vvatel/feline_follower/README.md

# Feline Follower (Autonomous Pet-Tracking Robot)
<strong>WORK IN PROGRESS</strong>
<p>An autonomous mobile robot that utilizes real-time visual tracking and SLAM-based navigation to follow the fast, erratic motions of a Felis catus in a real, unmapped and obstacle-ridden environment. Specifically, this robot will be tracking my own cat, Calypso, around my room and the hallways of the floor where I live.</p>
<p align="center">calypso</p>

## Details
<details><summary><ins><strong>Architecture</strong></ins></summary>
  
```
Desktop (ROS2/SLAM) <--Wi-Fi/ROS2--> Raspberry Pi 3B+ <--UART--> Arduino Uno R3 <--PWM--> TB6612FNG <--> 4x DC Motors
                                          ▲
                                          │ CSI
                                      Camera (OV5647)
```

</details>

<details>
<summary><strong><ins>Roadmap</ins></strong></summary>

<details><summary>Hardware: Data Exchange</summary>

#### Arduino <--> Motor Driver <--> Wheels

- [x] Verify TB6612 (motor driver) wiring on breadboard
- [x] Connect motor driver to Arduino Uno R3 using protoshield  
  *(need copper wire, soldering iron stand, solder sucker, cleaning sponge)*
- [x] Attach Uno to chassis, and connect DC motors to Uno through protoshield
- [x] Attach battery pack to chassis, and connect it to DC motors (as their power source) through motor driver
- [x] Verify that Uno is able to control all 4 wheels while attached to chassis

---

#### Raspberry Pi <--> Arduino

- [ ] Test UART communication only from Raspberry Pi 3B+ to Arduino Uno R3
- [ ] Using a breadboard, test UART communication from the Uno to Pi with a level shifter from 5V to 3.3V
- [ ] Solder level shifter to protoshield and set bi-directional UART communication through protoshield
- [ ] Verify communication between Pi and Uno
- [x] Create script for Uno to receive commands through Serial and write to motors
- [x] Verify that Pi is able to control all 4 wheels using Uno as intermediary

---

#### Desktop <--> Raspberry Pi

- [x] Figure out ROS2 communication between desktop and Raspberry Pi 3B+ over Wi-Fi  
  *(possibly need a router)*
- [x] Create bridge node on Pi for translating ROS2 Twist messages to workable PWM values that can be sent to Arduino
- [x] Verify that Pi is able to subscribe to topics, receive Twist messages, and use it to control the wheels

---

#### Desktop <--> Raspberry Pi <--> Arduino <--> Motor Driver <--> Wheels

- [ ] Verify full communication architecture with [Hand Controller](https://github.com/hcr-vvatel/hand_controller)

---

#### Camera <--> Raspberry Pi <--> Desktop

- [ ] Figure out how to send video feed from onboard camera to desktop

</details>

<details><summary>Software: Perception + Navigation</summary>

#### Perception Stack

- [ ] Research SLAM and find ROS2 implementations

---

#### Navigation Stack

- [ ] Figure out ROS2 Nav2 package

</details>
</details>

<details>
<summary><strong><ins>Timeline</ins></strong></summary>

<details><summary><strong>9/10/26</strong> - Conducted Testing to Calibrate Linear Speed to PWM Conversion</summary>
<p>Even though I could send Twist commands to my prototype vehicle, I still hadn't figured out how to make the car move as quickly or as slowly as I wanted. What PWM should I write to the motors such that they move the car at a specific linear speed. My first approach to solve this is to test the vehicle moving with different PWM percentages and seeing how long it takes it to travel 1 meter (for ease of conversion). For each PWM %, I collected 5 different run times so that I could average out any outliers in my data collection. Then, I used NumPy to fit a linear regression model predicting the underlying conversion equation and then plotted everything using MatPlotLib.</p>
  
Linear_Speed_Test_Figure_1
<p><b>Figure 9.10-1.</b> Each dot represents a different PWM % trialed, and the average of the 5 run times it took to travel 1 meter</p>
Linear_Speed_Test_Figure_2
<p><b>Figure 9.10-2.</b> Taking the inverse of the time reveals the underlying average speed of the vehicle at different PWM %'s</p>

<p>Using NumPy, I now had a model that could take in PWM %'s and predict the speed (m/s) that the vehicle would move at. Taking the inverse of this model now allows the vehicle to receive a specific speed (m/s) instruction (such as from a ROS2 Twist command) and have it output the PWM % it predicts the motors must receive to achieve that speed.</p>

<p><b>Notably:</b> I realize that this method will break if the underlying conversion equation changes for any reason such as differences in terrain or even battery output. In the future, I will look into closing the loop and using a sensor to determine the vehicle's actual speed and modify the PWM output in real time to reach a desired speed, but for now I'll simply try to replicate the testing conditions in which the data was collected as much as possible!</p>

</details>

---

<details><summary><strong>8/24/26</strong> - Completed first prototype of the Feline Follower</summary>
<p>Once I got all the motor wiring done, the final steps were just to put everything together, making sure to optimize the limited space that I had and the weight distribution of all the components.</p>

https://github.com/user-attachments/assets/06f4dbe5-0b82-4fd2-81a3-6a03bb42054f
<p><b>Figure 8.24-1.</b> Demo of FelineFollowerv1.0 spinning after receiving a ROS2 Twist command with only angular velocity</p>

<p>The full structure of this prototype includes a chassis with two layers. On the bottom layer is an Arduino Uno R3 velcroed to the frame controlling 4 Battery Operated DC Motors with a TB6612FNG Motor Driver. On the top layer, a rechargeable 12v battery pack which is used to power the motors and a power bank are velcroed to the frame. An encased Raspberry Pi 3B+ is velcroed to the top of the power bank which powers it. The Raspberry Pi is connected to a local router and listens to any Twist messages sent to the standard "/cmd_vel" topic, then translates those commands into PWM values sent through USB/Serial to the Arduino (this USB link also powers the Arduino), which then writes it to the motors.</p>

<p><b>Notably:</b> I didn't plan how to attach the camera to this build so I am planning to either buy a part that I can velcro onto the build and screw the camera into, or designing a custom part in CAD. I'm leaning towards designing a custom part since I don't have and want to gain experience with CAD, 3D Modeling and Printing, but this is supposed to be a computer vision project and I have already side-tracked quite a bit.

</details>

---

<details><summary><strong>8/19/26</strong> - Connected the motor's wires to the protoshield </summary>

<p>Now that I had the motor driver attached to the arduino, I could finally work on the wiring for the motors. Luckily, the protoshield that I used had multiple strips of connected holes allowing me to connect the motors and the motor driver easily.</p>
Motor Wiring
<p><b>Figure 8.19-1.</b> Motor <-> Motor Driver Wiring Diagram </p>

<p>Once I had finished wiring up the motors, I decided to test out the connections one more time before putting it all together. The Arduino was velcroed to the bottom layer of the frame, and the Raspberry Pi is running a <a href="ros2_ws/src/ros_serial_bridge/ros_serial_bridge/bridge.py">ROS2 node</a> that for now simply communicates through USB/Serial static PWM commands that the Arduino should write to the motors.</p>

https://github.com/user-attachments/assets/2925ada0-4e94-47b5-95f9-884456f6ebad
<p><b>Figure 8.19-2.</b> Demo of motors running while the wires are semi-permanenetly (soldered) to the Arduino</p>

</details>

---

<details> <summary><strong>8/16/26</strong> - Successfully connected motor driver to Arduino through protoshield </summary><br>

<p>Gathered the proper equipment including a new soldering iron, stand, a soldering tip cleaner, and copper wire. </p>

<p><b>Figure 8.16-1.</b> New protoshield held by recently acquired soldering stand</p>

<p>With all of this stuff, my second attempt at soldering the TB6612 onto the protoshield and then connecting it to the Arduino's pins was much cleaner. </p>

<p><b>Figure 8.16-2.</b> TB6612 - Arduino wiring using solder to connect copper wire at two points</p>

<p>I connected the protoshield and Arduino together and confirmed the TB6612FNG was working!</p>

<p><b>Figure 8.16-3.</b> Protoshield on top of Arduino Uno</p>

<p>Now comes the hard part, actually wiring the motors and power supply to the protoshield. My initial, brute force plan is to just connect pairs of holes on the protoshield together on the bottom with copper wire, then use each pair of holes, to connect pins on the Arduino, pins on the motor driver, and wires from the motors and battery pack together.</p>

</details>

---

<details> <summary><strong>8/2/26</strong> - Attempted to permanently set wiring between TB6612 and Arduino using a protoshield </summary><br>

<p>Bought some <a href="https://a.co/d/0bSkkdKM">protoshields</a> for the Arduino Uno R3, but they were physically incapable of seating on top of the Uno due to the heights of the ethernet port and power jack. To fix this, I used V-scoring to cut off an unnecessary part of the shield (<b>Figure 8.2-1</b>).</p>


<p><b>Figure 8.2-1.</b> Results of cutting protoshield; the red shield on top shows the original length.</p>

<p>After that, I soldered header pins onto the protoshield so that I could plug it into the female pins on the Arduino (<b>Figure 8.2-2</b>). The protoshield has a partner hole directly next to each solder joint, giving access to the underlying Arduino pin.</p>


<p><b>Figure 8.2-2.</b> Protoshield attached by header pins to the Arduino; the holes near each solder joint allow access to the actual Arduino pins.</p>

<p><b>Notably:</b> For some of the pins, a bit of solder fell and clogged their partnered hole due to lack of experience. In the future, I should obtain a solder sucker to fix mistakes like this.</p>

<p>I then soldered the motor driver onto the protoshield and attempted to use lines of solder to replicate the wiring between the motor driver and the Arduino. On the surface, solder connects the partner holes to holes near the motor driver; underneath, solder connects the holes near the motor driver to the motor driver's pins (<b>Figure 8.2-3</b>).</p>


<p><b>Figure 8.2-3.</b> Motor driver soldered onto protoshield; the raised lines of solder are used as wire to bridge the motor driver and Arduino.</p>

<p><b>Notably:</b> Lacking equipment such as a sponge to clean the soldering iron and a stand to hold it while hot made this very difficult and time-consuming. Without being able to clean the iron of buildup, it was hard to make tiny, precise connections without accidentally creating a short circuit. In the future, I should obtain a soldering iron stand. Additionally, using solder as both the wire and the connector is difficult — in the future, I should obtain and use copper wire instead.</p>

<p>Ultimately, this attempt failed. I'll get the proper equipment and supplies before trying again.</p>

</details>

---

<details> <summary><strong>7/31/26</strong> - Verified TB6612 (Motor Driver) control logic on breadboard</summary><br>

<p>Bought a <a href="https://a.co/d/0d0911Pa">TB6612 Motor Driver</a> and soldered the header pins onto it. I tested the wiring between the Arduino, the motor driver, and one of the car's motors using a breadboard. Then, I wrote a <a href="arduino/tests/motor_driver_test/motor_driver_test.ino">script</a> to test the motor driver's control logic (<b>Figure 7.31-1</b>).</p>

https://github.com/user-attachments/assets/8c097552-bbd2-4168-9c4e-e303f9cf0ce9
<p><b>Figure 7.31-1.</b> Motor driver control logic test — STBY, AIN1/AIN2, and PWMA signals verified with a multimeter before connecting battery power.</p>

<p><b>Issue:</b> After wiring in battery power, STBY unexpectedly read 0V. STBY needs to constantly be set to HIGH, otherwise the motor driver operates in sleep mode. Isolated the fault via systematic voltage tracing using a multimeter and found a cold solder joint on the STBY header pin. Reheating the joint solved the issue.</p>

</details>

---

<details> <summary><strong>7/26/26</strong> - Redesigned robot control architecture from initial AV kit</summary><br>
<p>Purchased a cheap autonomous vehicle kit shown below, hoping I could minimally alter it for the needs of this project and focus mostly on writing the software.</p>

Elegoo Smart Car
<p><b>Figure 7.1-1.</b> ELEGOO Smart Robot Car Kit V4.0, as originally assembled.</p>
<p>From the original architecture of the kit, my initial plan was to establish communication with a host computer running ROS2 to the onboard Arduino using an ESP32-S3 microcontroller (included with the kit) as the intermediary. I found that the I/O Expansion shield (placed on top of the Arduino) and the ESP32 were too customized/undocumented to extend for this project. I decided to scrap both parts, and instead use a different microcontroller as the intermediary.</p>
<p><b>Notably:</b> Because of this replacement, I lost access to the motor driver (TB6612FNG) attached to the I/O Expansion Shield, so I would need to wire in one on my own.</p>
<p>
  For the intermediary, I chose to use the Raspberry Pi Model 3 B+ (<b>Figure 7.26-1</b>). This Pi was chosen mainly due to budget constraints. Since the project will initially run most computations through my desktop, the Pi only needs enough power to broadcast images over Wi-Fi, run ROS2 to receive commands, and translate those commands into workable Serial that can be written to the motors. Though a stronger Pi could run the computations itself, it is too expensive at the moment. The final structure will look like:
</p>
<p>Host Computer &lt;---ROS2 Messages---&gt; RPi 3B+ &lt;----Serial----&gt; Arduino</p>

Raspberry Pi 3B+
<p><b>Figure 7.26-1.</b> Raspberry Pi Model 3 B+, chosen as the desktop to Arduino intermediary.</p>

</details>

</details>
