vvatel/feline_follower/testing/figures/Linear_Speed_Test_Figure_1.png

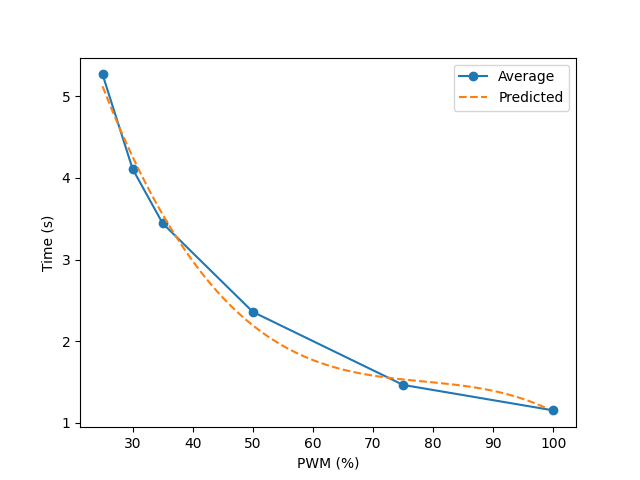
testing/figures/Linear_Speed_Test_Figure_1.png
