vvatel/feline_follower/testing/figures/Linear_Speed_Test_Figure_2.png

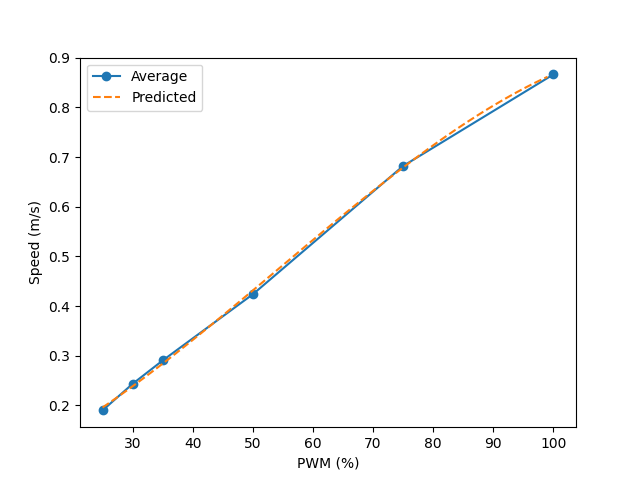
testing/figures/Linear_Speed_Test_Figure_2.png
