vvatel/feline_follower/(commit log)

2026-08-02 Revise progress timeline in README.md
    Updated progress timeline with detailed descriptions of recent milestones, including motor driver control logic verification and redesign of robot control architecture.
2026-08-17 Update README with wiring details and task progress
    Updated task list and added details about wiring and equipment used for connecting TB6612 to Arduino.
2026-09-11 progress on speed calibration
2026-09-11 finished linear velocity calibration, next working on angular velocity
2026-09-11 added demo video showing motors working while semi-permanently wired
2026-09-11 Finished ReadMe Update for 8/19/26
    Updated wiring instructions and added demo video for motors.
2026-09-11 Inserted video without audio to readme
2026-09-12 ReadMe Update (8.24.26): First prototype of vehicle completed
    Added details about the Feline Follower prototype, including its structure and components used.
2026-09-12 ReadMe Update (9/10/26): Linear Regression Model for Predicting PWM from Speed
